demianmozo/proyecto_laberinto/Algoritmos_de_escape_implementados_en_hardware__SASE_2025.pdf

Algoritmos de escape implementados en hardware.

### Ian P. Larrieu Lacoste y Demian N. Mozo

Depto. de Electronica y Computaci ´ | on, Facultad de Ingenier ´ | ía - UNMDP

### Mar del Plata, 7600, Argentina. Julio 2025 {ianlarrieu, dmozo}@alumnos.fi.mdp.edu.ar

Resumen—En este trabajo se presenta la implementacion de un sistema de control digital sobre FPGA para ´
un robot autonomo capaz de detectar obst ´ | aculos, ajustar ´
su trayectoria y resolver un laberinto desconocido. La navegacion se basa en un algoritmo de llenado (flood fill), ´ que permite construir un mapa del entorno y encontrar el camino mas corto hacia la salida. La arquitectura ´ implementada aprovecha la paralelizacion que ofrece ´ el hardware configurable, logrando un comportamiento eficiente en tiempo real.

Palabras clave—FPGA, VHDL, Robot, Maze-solver, Flood-fill.
I. INTRODUCCION´

Este proyecto se desarrollo en la asignatura ´
Tecnicas y Dispositivos Digitales II (3er a ´ | no de ˜
Ingeniería Electronica). En esta materia se abordan ´
temas de diseno digital, una introducci ˜ | on a los dis- ´
positivos logicos programables, entre ellos FPGAs. ´
La resolucion de laberintos es un problema cl ´ | asi- ´
co en robotica y teor ´ | ía de grafos, que consiste en
encontrar una ruta eficiente desde una posicion ini- ´ cial hasta un destino dentro de un entorno complejo. El robot debe evitar obstaculos y seleccionar una ´
trayectoria optima seg ´ | un criterios como distancia ´
o tiempo. En escenarios dinamicos, tambi ´ | en debe ´
adaptarse en tiempo real ante cambios en el entorno. Este problema es relevante en aplicaciones como
navegacion aut ´ | onoma y log ´ | ística en almacenes.
Muchos algoritmos de navegacion se desarrollan ´ sobre microcontroladores o microprocesadores. Un ejemplo comun son las placas Arduino basadas en ´ microcontroladores de la familia ATmega, utilizadas en [1], [2] y [3]. En este ultimo, se emplean ´ dos variantes del algoritmo —el basico (FFA) y una ´ version modificada (MFFA)— junto con sensores ´
ultrasonicos para navegaci ´ | on aut ´ | onoma en entornos ´
desconocidos.
La implementacion de estos algoritmos en hard- ´ ware, particularmente en FPGAs, permitiría una
ejecucion m ´ | as r ´ | apida y eficiente, especialmente ´
en aquellos casos donde puede aprovecharse su naturaleza concurrente. A pesar de las ventajas que ofrecen las soluciones basadas en logica reconfigu- ´ rable —como el paralelismo, la alta velocidad y la eficiencia energetica—, hasta donde alcanza nuestro ´ conocimiento no se han reportado implementaciones de este tipo. Esto puede atribuirse a los desafíos que implica el diseno de arquitecturas distribuidas ˜ y el uso de lenguajes de descripcion de hardware. ´ En este proyecto se disena e implementa el ˜ algoritmo de llenado (flood-fill) mediante una arquitectura completamente paralela sobre FPGA, en la que el laberinto es modelado como una matriz de celdas interconectadas. Esta propuesta permite resolver el laberinto en tiempo real, y a la vez explora las ventajas del procesamiento distribuido aplicado a sistemas embebidos de navegacion. ´

I-A. Algoritmo de llenado
El algoritmo de llenado utilizado se basa en una estrategia exploratoria, en la que el robot parte del supuesto de un entorno libre de obstaculos. ´ A medida que avanza, actualiza dinamicamente un ´ mapa interno, asignando a cada celda un valor que representa la distancia al objetivo y marcando como inaccesibles aquellas celdas adyacentes a los muros detectados por sus sensores. Esta informacion se ´ emplea para recalcular rutas optimas, permitiendo ´ que el robot se adapte progresivamente al entorno real y construya su propio mapa del laberinto [3].

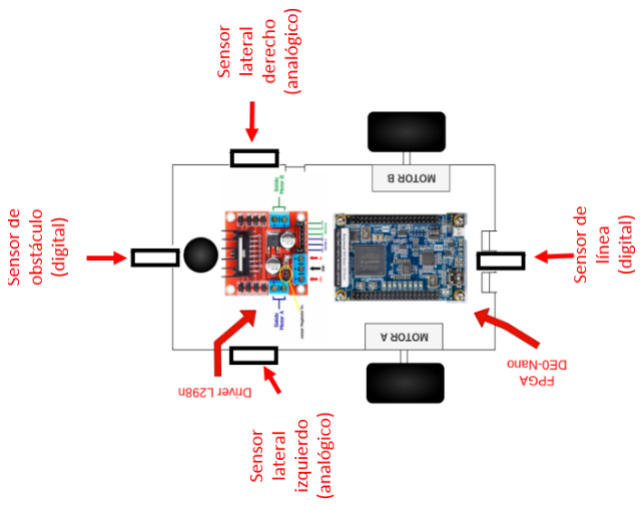
[picture p1: figure]

Figura 1. Esquema funcional del robot implementado.

II. IMPLEMENTACION´

II-A. Robot
El robot de la Fig.1 incorpora dos motores de corriente continua controlados por un driver L298N [4]. Ademas, dispone de un sensor frontal digital, ´
un sensor digital para deteccion de l ´ | ínea, y dos
sensores laterales infrarrojos analogicos. ´
El control y procesamiento de los datos de los sensores, así como el accionamiento de los motores, se gestionan en una DE0-Nano Field Programmable

Gate Arrays (FPGAs) de Altera [5]. En esta FPGA se implementa el algoritmo de navegacion, el cual ´ regula los movimientos del robot en funcion de las ´ lecturas de los sensores. Los sensores infrarrojos laterales estan conectados a dos canales de un ´ conversor Analogico-Digital (ADC) integrado en la ´ placa de desarrollo. Este ADC es gestionado por la FPGA para recibir en tiempo real la informacion´ de distancia de los laterales del robot, permitiendo así un desplazamiento recto y estable.

II-B. Laberinto
El laberinto de la Fig.2 esta construido en made- ´ ra, con columnas impresas en 3D, y disenado con ˜ cuadrículas delimitadas por líneas negras detecta-
bles por el robot. Ademas, cada cuadr ´ | ícula esta con- ´
figurada para permitir la incorporacion de muros, ´ lo que permite ajustar y variar la complejidad del laberinto para diferentes escenarios de navegacion. ´

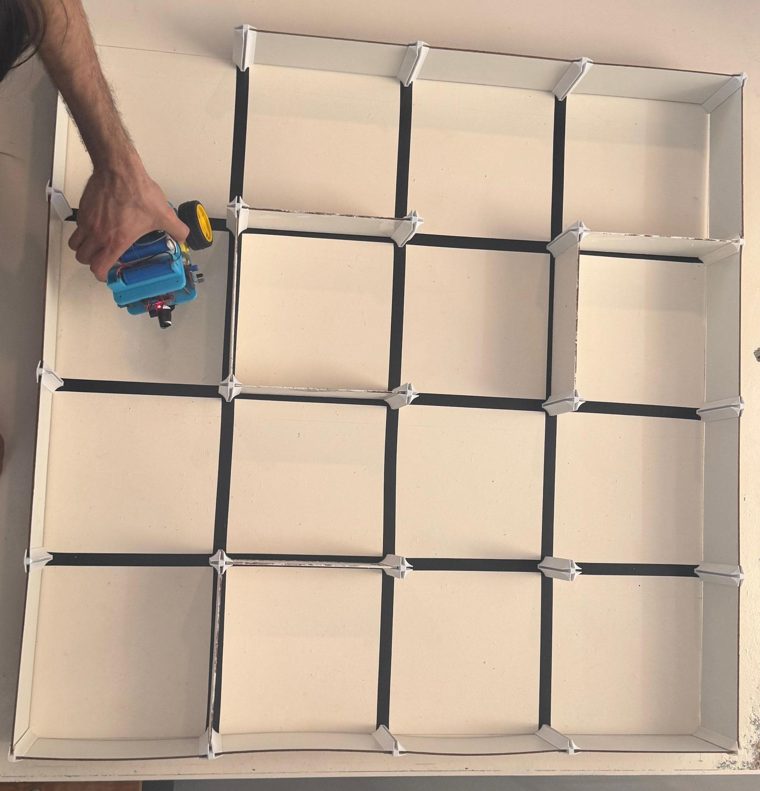
[picture p2: figure]

Figura 2. Laberinto implementado con paredes rebatibles.

III. CONTROL DEL ROBOT
El algoritmo de llenado fue implementado en una FPGA con el objetivo de resolver un laberinto de 4 × 4. Para modelar el entorno, se disenõ una ´ arquitectura modular basada en celdas, donde cada celda representa una posicion del laberinto. Cada ´ celda fue implementada como una unidad funcional en VHDL (Fig. 3), con capacidad para interactuar con sus celdas vecinas. Cada bloque de celda recibe como entradas:
La informacion sobre muros en las cuatro direc- ´ ciones (N, S, E, O).
Los valores de peso (distancia estimada al objetivo) provenientes de las celdas adyacentes. Con esta informacion, la celda calcula su propio ´ peso siguiendo una logica simple: adopta el menor ´ peso de sus vecinos accesibles (es decir, aquellos sin muro en comun) y le suma una unidad. Luego, ´ transmite su peso actualizado y su configuracion´ de muros hacia las celdas vecinas, propagando la informacion a lo largo de toda la red. ´
Al interconectar las 16 celdas en una matriz, se forma un laberinto completo en el que cada celda

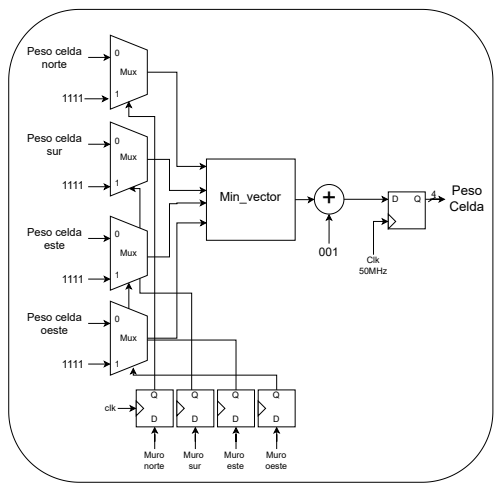
[picture p3: figure]
Min_vector; Peso Celda; Muro norte; Peso celda norte; Mux; Clk 50MHz; Peso celda; sur; Peso celda este; Peso celda oeste; clk; Muro sur; Muro este; Muro oeste

Figura 3. Esquematico combinacional de una celda. ´

actua localmente, pero contribuye al comportamien- ´ to global del sistema. Esta estructura distribuida permite que el algoritmo sea altamente paralelizable y se ejecute eficientemente en hardware. Durante
la exploracion f ´ | ísica del entorno, el robot actualiza
dinamicamente la informaci ´ | on de muros en las ´
celdas correspondientes, lo que fuerza una nueva propagacion de pesos. De esta forma, el sistema ´ converge progresivamente hacia una representacion´ real del laberinto, y el robot puede decidir su
proximo movimiento bas ´ | andose en los pesos m ´ | as´
bajos disponibles en las celdas accesibles.

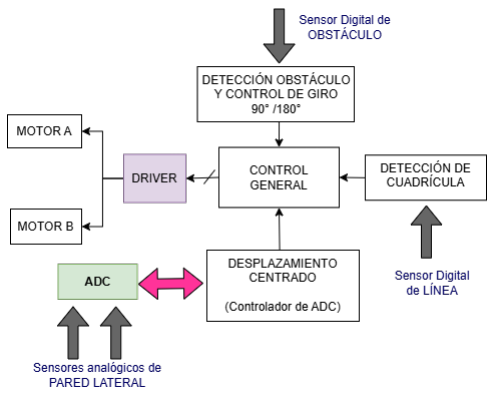
[picture p4: figure]

Figura 4. Esquema del control implementado.

Una vez propagados los pesos, el robot evaluá las celdas adyacentes y selecciona aquella con el menor peso, siempre que no haya un muro que impida el paso. Tras avanzar a una nueva celda, actualiza la informacion local detectando la pre- ´ sencia de muros mediante el sensor frontal. Estos datos se almacenan en la celda correspondiente del
laberinto y se comparten con las demas a trav ´ | es de ´
las interconexiones. Si se detectan cambios en la

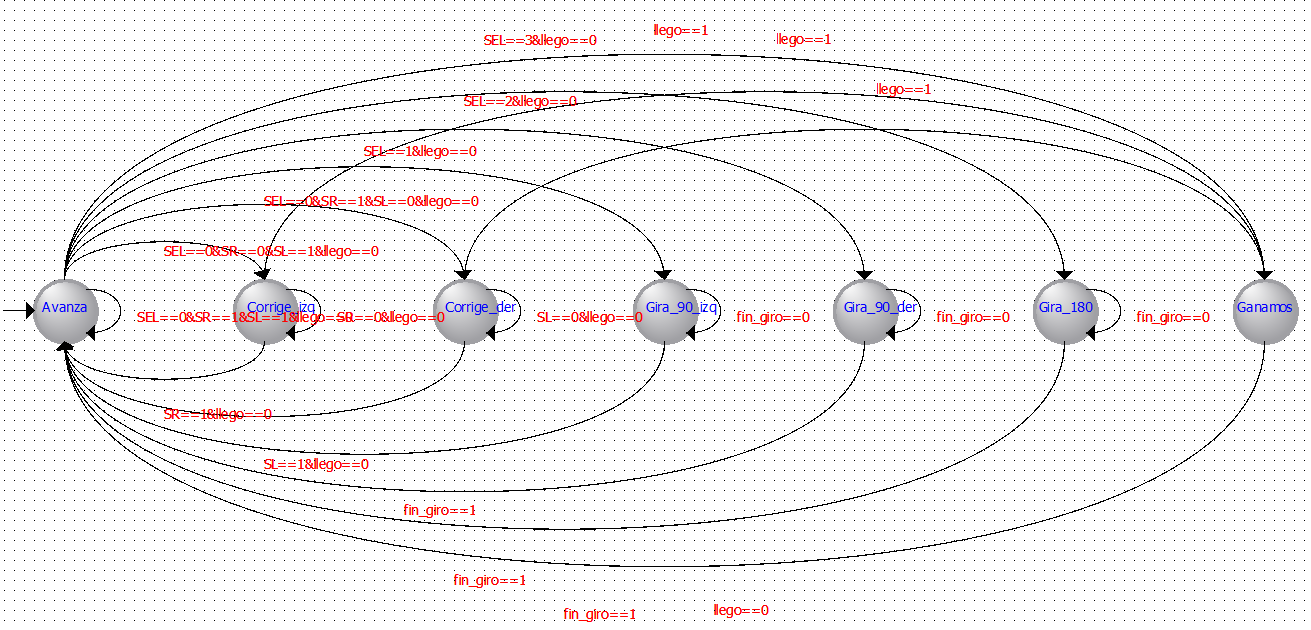
[picture p5: figure]

Figura 5. Diagrama de estados: control de motores.

topología, se desencadena una nueva propagacion. ´ El sistema de movimiento permite giros de ±90◦ o 180◦
segun sea necesario para alinearse con la celda ´ elegida. Esta logica le permite adaptarse de forma ´ eficiente a las condiciones reales del entorno. Cuando el robot alcanza la celda objetivo, se detiene y queda a la espera de nuevas instrucciones. El sistema incorpora un mecanismo de reinicio parcial mediante un pulsador externo: al activarse,
se reinicia unicamente la posici ´ | on actual del robot, ´
conservando la memoria de los muros previamente detectados. Así, en ejecuciones sucesivas, el robot navega hacia el objetivo sin necesidad de volver a explorar. La Fig. 4 muestra un esquema del control implementado en la FPGA, destacando las funcionalidades necesarias para el desplazamien-
to: deteccion de obst ´ | aculos y giro, desplazamiento ´
centrado, control de motores y conteo de celdas atravesadas.

Funciones del sistema de control
Desplazamiento centrado y control de motores: se implementa mediante una maquina de ´ estados que comanda los motores en tiempo real (Fig. 5). Por ejemplo, el robot avanza en línea recta utilizando los sensores laterales, si el valor entregado por los sensores (entradas al ADC) es menor a un umbral, se ajusta la direccion para ´ alejarse de la pared. Por otro lado, si el control general decide que se debe realizar un giro para cambiar de casilla, este bloque ejecuta la accion. ´
Deteccion de obst ´ | aculos y giro: ´ | el robot emplea
el sensor frontal para detectar muros. Si un muro es detectado, el sistema acciona los motores y ejecuta giros de 90◦ o 180◦
Deteccion de cuadr ´ | | ícula: mediante un sensor de
línea, se detecta el cruce entre celdas. Esta senal ˜ actualiza la posicion actual del robot. ´
Control general y logica de decisi ´ | on: ´ | este
modulo selecciona la estrategia de navegaci ´ | | on y ´
decide el proximo movimiento en funci ´ | on de la ´
informacion disponible. ´
La implementacion completa de este trabajo, ´
incluyendo el diseno en VHDL y la documentaci ˜ | | on´
correspondiente, se encuentra disponible en [6].

IV. CONCLUSIONES Y TRABAJO FUTURO
Se integraron con exito los sensores y motores ´ del robot controlados por FPGA, permitiendo una respuesta en tiempo real clave para la navegacion´ en el laberinto. A futuro, se evaluara la escalabi- ´ lidad del sistema para entornos mas complejos y ´ aplicaciones industriales, como automatizacion en ´ almacenes o inspeccion en ambientes peligrosos, ´ requiriendo pruebas en condiciones reales. Ademas, la FPGA ofrece una ventaja signifi- ´ cativa al permitir la ejecucion paralela de tareas ´
como deteccion de muros, actualizaci ´ | on del mapa ´
y control de motores, evitando interferencias y retrasos típicos de microprocesadores secuenciales, que pueden bloquear tareas y provocar perdidas ´ durante la navegacion. ´

REFERENCIAS

[1] I. Elshamarka and A. B. S. Saman, “Design and implementation of a robot for maze-solving using flood-fill algorithm,” International Journal of Computer Applications, vol. 56, no. 5, 2012.
[2] S. Tjiharjadi, “Design and implementation of flood fill and pledge algorithm for maze robot,” International Journal of Mechanical Engineering and Robotics Research, 2019.
[3] Nadour and Cherroun, “Using flood-fill algorithms for an autonomous mobile robot maze navigation,” International Journal of System Assurance Engineering and Management, 2022.
[4] STMicroelectronics, “L298N Dual Full Bridge Driver -Datasheet,” https://www.handsontec.com/dataspecs/L298N%20Motor%20Driver.pdf, 2000, accessed: 2025-06-15.
[5] DE0-Nano User Manual, Terasic Inc., 2016.
[6] D. N. Mozo, “Proyecto escape de laberinto - robot autonomo en ´ fpga,” https://github.com/demianmozo/proyecto laberinto, 2024.
