demianmozo/proyecto_laberinto/(list of files, cad)

Other CAD files:
Ratatouille/output_files/output_files/stp_auto_stripped.stp
Ratatouille/simulation/modelsim/gate_work/tb_temporizador_doble/behavioral.psm
Ratatouille/simulation/modelsim/gate_work/temporizador_doble/structure.psm
Ratatouille/simulation/modelsim/rtl_work/motores/behavior.psm
Ratatouille/simulation/modelsim/rtl_work/tb_control_motores/behavior.psm
Ratatouille/simulation/modelsim/rtl_work/temporizador_doble/behavioral.psm
Ratatouille/simulation/qsim/work/@celda/verilog.psm
Ratatouille/simulation/qsim/work/@celda_vlg_check_tst/verilog.psm
Ratatouille/simulation/qsim/work/@celda_vlg_sample_tst/verilog.psm
Ratatouille/simulation/qsim/work/@celda_vlg_vec_tst/verilog.psm
Ratatouille/simulation/qsim/work/@control_@motores/verilog.psm
Ratatouille/simulation/qsim/work/@control_@motores_vlg_check_tst/verilog.psm
Ratatouille/simulation/qsim/work/@control_@motores_vlg_sample_tst/verilog.psm
Ratatouille/simulation/qsim/work/@control_@motores_vlg_vec_tst/verilog.psm
Ratatouille/simulation/qsim/work/@d@f@f_fijo/verilog.psm
Ratatouille/simulation/qsim/work/@d@f@f_fijo_vlg_check_tst/verilog.psm
Ratatouille/simulation/qsim/work/@d@f@f_fijo_vlg_sample_tst/verilog.psm
Ratatouille/simulation/qsim/work/@d@f@f_fijo_vlg_vec_tst/verilog.psm
Ratatouille/simulation/qsim/work/@matriz_ubicacion/verilog.psm
Ratatouille/simulation/qsim/work/@matriz_ubicacion_vlg_check_tst/verilog.psm
Ratatouille/simulation/qsim/work/@matriz_ubicacion_vlg_sample_tst/verilog.psm
Ratatouille/simulation/qsim/work/@matriz_ubicacion_vlg_vec_tst/verilog.psm
Ratatouille/simulation/qsim/work/@s@e@n@t_@a@c@t@u@a@l/verilog.psm
Ratatouille/simulation/qsim/work/@s@e@n@t_@a@c@t@u@a@l_vlg_check_tst/verilog.psm
Ratatouille/simulation/qsim/work/@s@e@n@t_@a@c@t@u@a@l_vlg_sample_tst/verilog.psm
Ratatouille/simulation/qsim/work/@s@e@n@t_@a@c@t@u@a@l_vlg_vec_tst/verilog.psm
Ratatouille/simulation/qsim/work/control/verilog.psm
Ratatouille/simulation/qsim/work/control_vlg_check_tst/verilog.psm
Ratatouille/simulation/qsim/work/control_vlg_sample_tst/verilog.psm
Ratatouille/simulation/qsim/work/control_vlg_vec_tst/verilog.psm
Ratatouille/simulation/qsim/work/decido_accion/verilog.psm
Ratatouille/simulation/qsim/work/decido_accion_vlg_check_tst/verilog.psm
Ratatouille/simulation/qsim/work/decido_accion_vlg_sample_tst/verilog.psm
Ratatouille/simulation/qsim/work/decido_accion_vlg_vec_tst/verilog.psm
Ratatouille/simulation/qsim/work/elijo_sentido/verilog.psm
Ratatouille/simulation/qsim/work/elijo_sentido_vlg_check_tst/verilog.psm
Ratatouille/simulation/qsim/work/elijo_sentido_vlg_sample_tst/verilog.psm
Ratatouille/simulation/qsim/work/elijo_sentido_vlg_vec_tst/verilog.psm
Ratatouille/simulation/qsim/work/purbea/verilog.psm
Ratatouille/simulation/qsim/work/purbea_vlg_check_tst/verilog.psm
Ratatouille/simulation/qsim/work/purbea_vlg_sample_tst/verilog.psm
Ratatouille/simulation/qsim/work/purbea_vlg_vec_tst/verilog.psm
Ratatouille/simulation/qsim/work/seleccionadores_mux/verilog.psm
Ratatouille/simulation/qsim/work/seleccionadores_mux_vlg_check_tst/verilog.psm
Ratatouille/simulation/qsim/work/seleccionadores_mux_vlg_sample_tst/verilog.psm
Ratatouille/simulation/qsim/work/seleccionadores_mux_vlg_vec_tst/verilog.psm
Ratatouille/simulation/qsim/work/sumador_habilitacion/verilog.psm
Ratatouille/simulation/qsim/work/sumador_habilitacion_vlg_check_tst/verilog.psm
Ratatouille/simulation/qsim/work/sumador_habilitacion_vlg_sample_tst/verilog.psm
Ratatouille/simulation/qsim/work/sumador_habilitacion_vlg_vec_tst/verilog.psm
