demianmozo/proyecto_laberinto/Ratatouille/simulation/qsim/work/@control_@motores_vlg_check_tst/_primary.vhd

library verilog;
use verilog.vl_types.all;
entity Control_Motores_vlg_check_tst is
    port(
        ADC_CS_N        : in     vl_logic;
        ADC_DIN         : in     vl_logic;
        ADC_SCLK        : in     vl_logic;
        CH0             : in     vl_logic_vector(11 downto 0);
        CH1             : in     vl_logic_vector(11 downto 0);
        CLK1MHz         : in     vl_logic;
        CLK10KHz        : in     vl_logic;
        clk_40KHz       : in     vl_logic;
        LedIRd          : in     vl_logic;
        LedIRi          : in     vl_logic;
        MD0             : in     vl_logic;
        MD1             : in     vl_logic;
        MI0             : in     vl_logic;
        MI1             : in     vl_logic;
        VELD            : in     vl_logic;
        VELI            : in     vl_logic;
        sampler_rx      : in     vl_logic
    );
end Control_Motores_vlg_check_tst;
