demianmozo/proyecto_laberinto/Ratatouille/simulation/qsim/work/@s@e@n@t_@a@c@t@u@a@l_vlg_check_tst/_primary.vhd

library verilog;
use verilog.vl_types.all;
entity SENT_ACTUAL_vlg_check_tst is
    port(
        q_out           : in     vl_logic_vector(1 downto 0);
        sampler_rx      : in     vl_logic
    );
end SENT_ACTUAL_vlg_check_tst;
