demianmozo/proyecto_laberinto/Ratatouille/simulation/qsim/work/purbea_vlg_check_tst/_primary.vhd

library verilog;
use verilog.vl_types.all;
entity purbea_vlg_check_tst is
    port(
        pin_name1       : in     vl_logic;
        sampler_rx      : in     vl_logic
    );
end purbea_vlg_check_tst;
