demianmozo/proyecto_laberinto/Ratatouille/simulation/qsim/work/seleccionadores_mux_vlg_sample_tst/_primary.vhd

library verilog;
use verilog.vl_types.all;
entity seleccionadores_mux_vlg_sample_tst is
    port(
        X               : in     vl_logic_vector(3 downto 0);
        sampler_tx      : out    vl_logic
    );
end seleccionadores_mux_vlg_sample_tst;
