demianmozo/proyecto_laberinto/(commit log)

2024-11-08 somos crack demiana linda
    [LineaRecta.smp_dump.txt, stp2.stp, stp2_auto_stripped.stp]
2024-11-12 Con esfuerzo y esperanza todo se alcanza.
    [LineaRecta.smp_dump.txt, ratatouille.smp_dump.txt, stp2.stp, stp2_auto_stripped.stp]
2024-11-14 nuestra mayor gloria no es no haber caido nunca, sino levantarnos cada vez que caemos
2024-11-14 La tragedia no es no alcanzar tus objetivos, la tragedia es no tener objetivos que alcanzar.
2024-11-14 La diferencia entre la comedia y la tragedia es que en la comedia sus personajes encuentran la forma de sobreponerse a la tragedia.
2024-11-14 Resiliencia: capacidad para adaptarse a las situaciones adversas con resultados positivos.
2024-11-15 No sueñes con el exito, trabaja para lograrlo
2024-11-15 Arranca por la derecha el genio del Quartus mundial
    [ratatouille.smp_dump.txt]
2024-11-19 Cuando todo parezca ir contra ti, recuerda que el avión despega contra el viento, no a favor de él.
2024-11-19 Aunque los justos caen siete veces, resucitan, pero los impíos tropiezan con la calamidad.
    [verilog.psm]
2024-11-20 El goteo del agua hace un hueco en el agua, no por la fuerza, sino por la persistencia.
    [verilog.psm]
2024-11-21 'El fracaso es el mejor maestro.' – Yoda
2024-11-21 No hay victoria sin sacrificio.
    [ratatouille.smp_dump.txt]
2024-11-21 Para ganar la carrera primero hay que llegar.Fangio
2024-11-22 Llegar al área y no poder patear al arco es como bailar con tu hermana. Diego Armando Maradona.
    [behavior.psm, behavioral.psm, ratatouille.smp_dump.txt, structure.psm, verilog.psm]
2024-11-22 A dios rogando y con el mazo dando
    [behavior.psm, behavioral.psm, ratatouille.smp_dump.txt, stp1.stp, stp1_auto_stripped.stp, structure.psm, verilog.psm]
2024-11-23 Empieza haciendo lo necesario, después lo posible y, de repente, te encontrarás haciendo lo imposible
2024-11-24 Todos los años hay un campeón, pero no siempre hay un gran campeón. Ayrton Senna
    [stp1.stp, stp1_auto_stripped.stp, verilog.psm]
2024-11-25 Cambio de configuracion de carga aerodinamica
    [ratatouille.smp_dump.txt, stp1.stp, stp1_auto_stripped.stp, verilog.psm]
2024-11-26 No hay que hacerse de enemigos que no están en la altura del conflicto. Gustavo 'Lechuga' Alfaro.
    [ratatouille.smp_dump.txt, stp1.stp, stp1_auto_stripped.stp, verilog.psm]
2024-11-26 La gloria no tiene precio.Miguel Angel Russo
    [verilog.psm]
2024-11-26 Cambios a 4 bits
    [ratatouille.smp_dump.txt]
2024-11-26 Llegué, ví y vencí - Julio César
    [ratatouille.smp_dump.txt, stp3.stp, stp3_auto_stripped.stp, verilog.psm]
2024-11-28 Siempre 1/4 de milla a la vez - Toretto
    [ratatouille.smp_dump.txt]
2025-07-25 A mí me gusta tanto la noche... que al día le pondría un toldo
    [ratatouille.smp_dump.txt, verilog.psm]
2025-07-28 Me voy contento de Japón la maquiniita funciona. Coco Basile
    [stp_auto_stripped.stp]
2025-07-29 'hay que ganar siempre'
